Shan-boop-cmd/Saathi_Chair/Hardware/Samples/foot impedance circuit.png

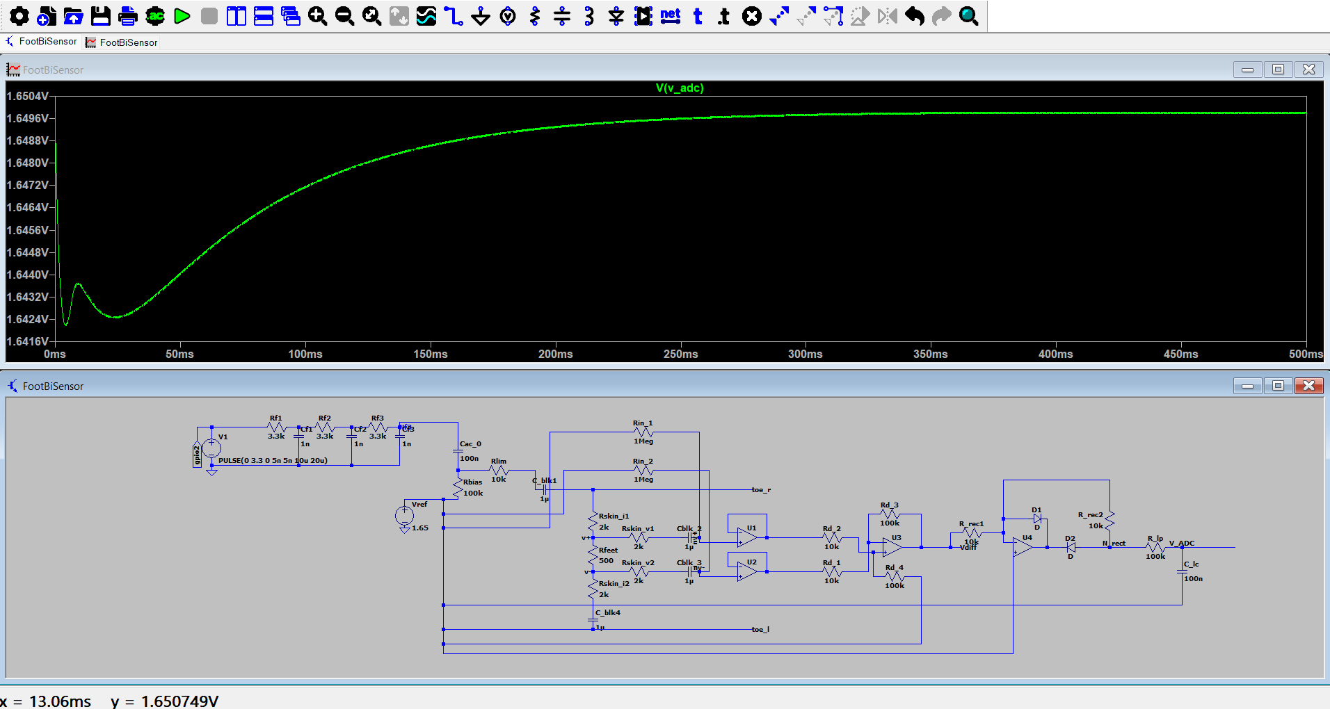
Hardware/Samples/foot impedance circuit.png
