Shan-boop-cmd/Saathi_Chair/Hardware/Samples/opamp circuit_PVDF.jpeg

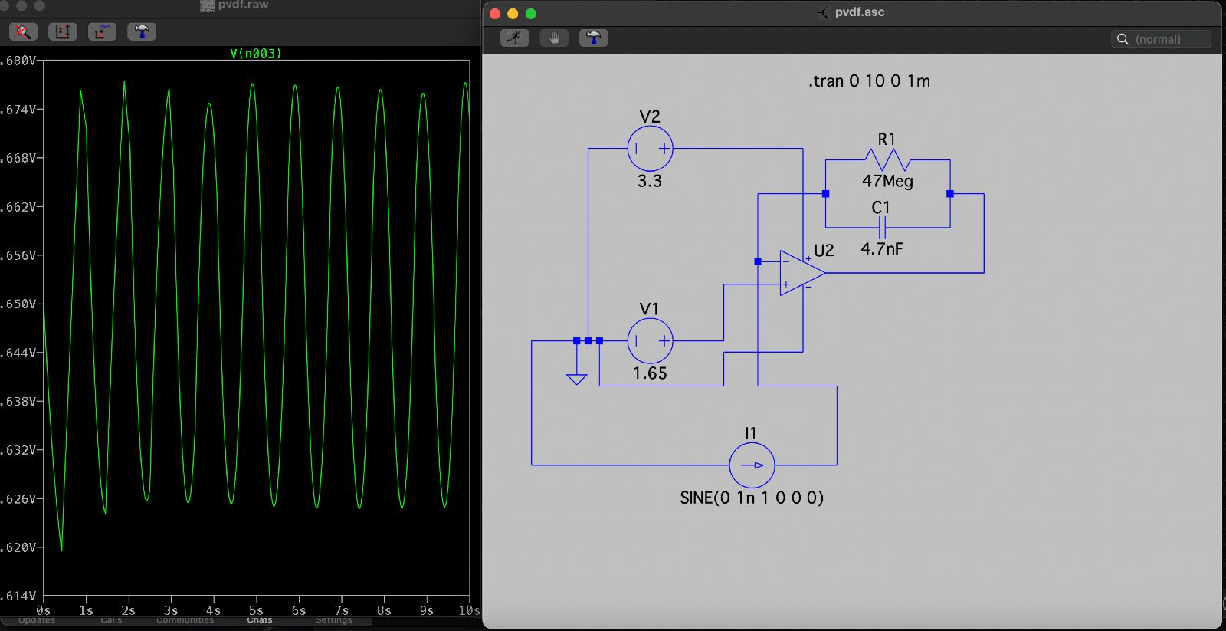
Hardware/Samples/opamp circuit_PVDF.jpeg
