Shan-boop-cmd/Saathi_Chair/Hardware/Schematics/schematic_bcg_frontend.png

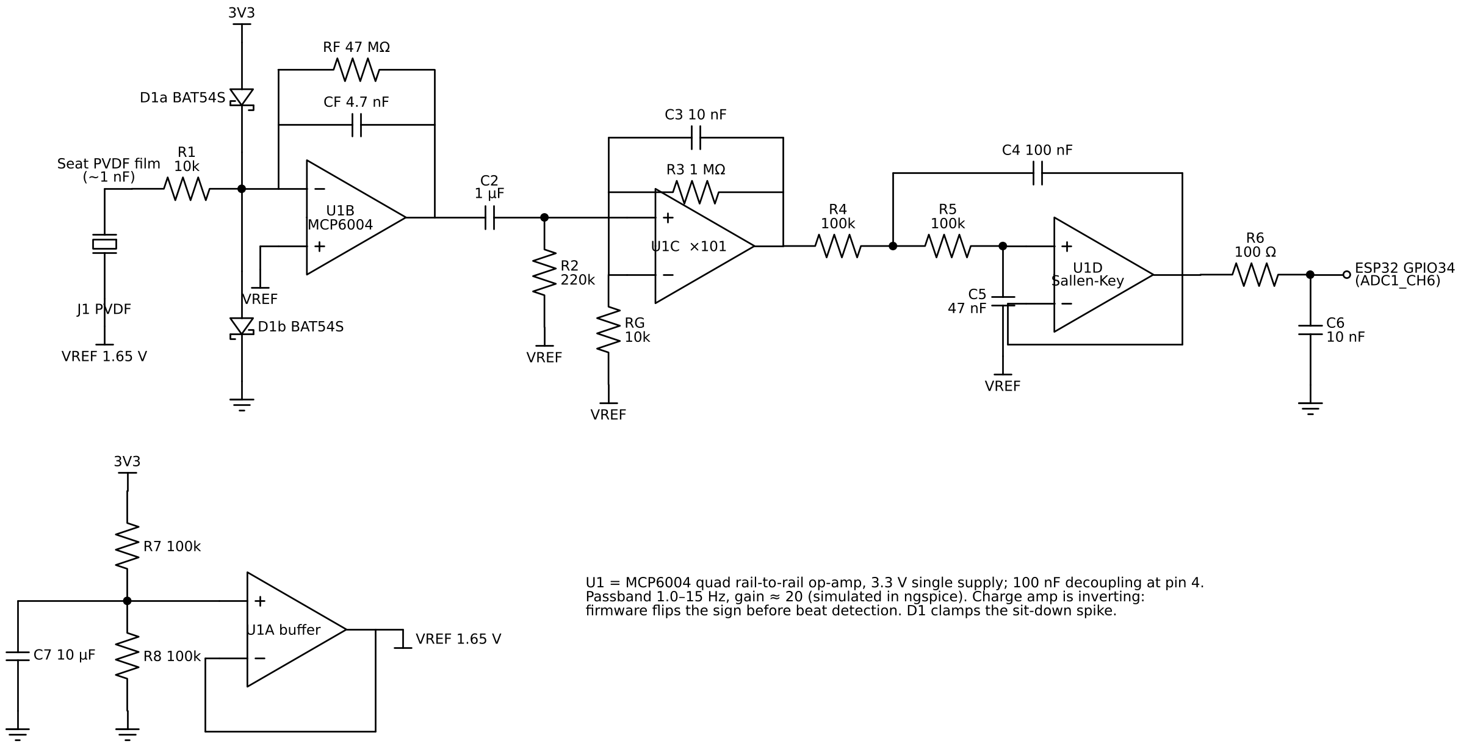
Hardware/Schematics/schematic_bcg_frontend.png
