Shan-boop-cmd/Saathi_Chair/Hardware/Schematics/schematic_bioimpedance.png

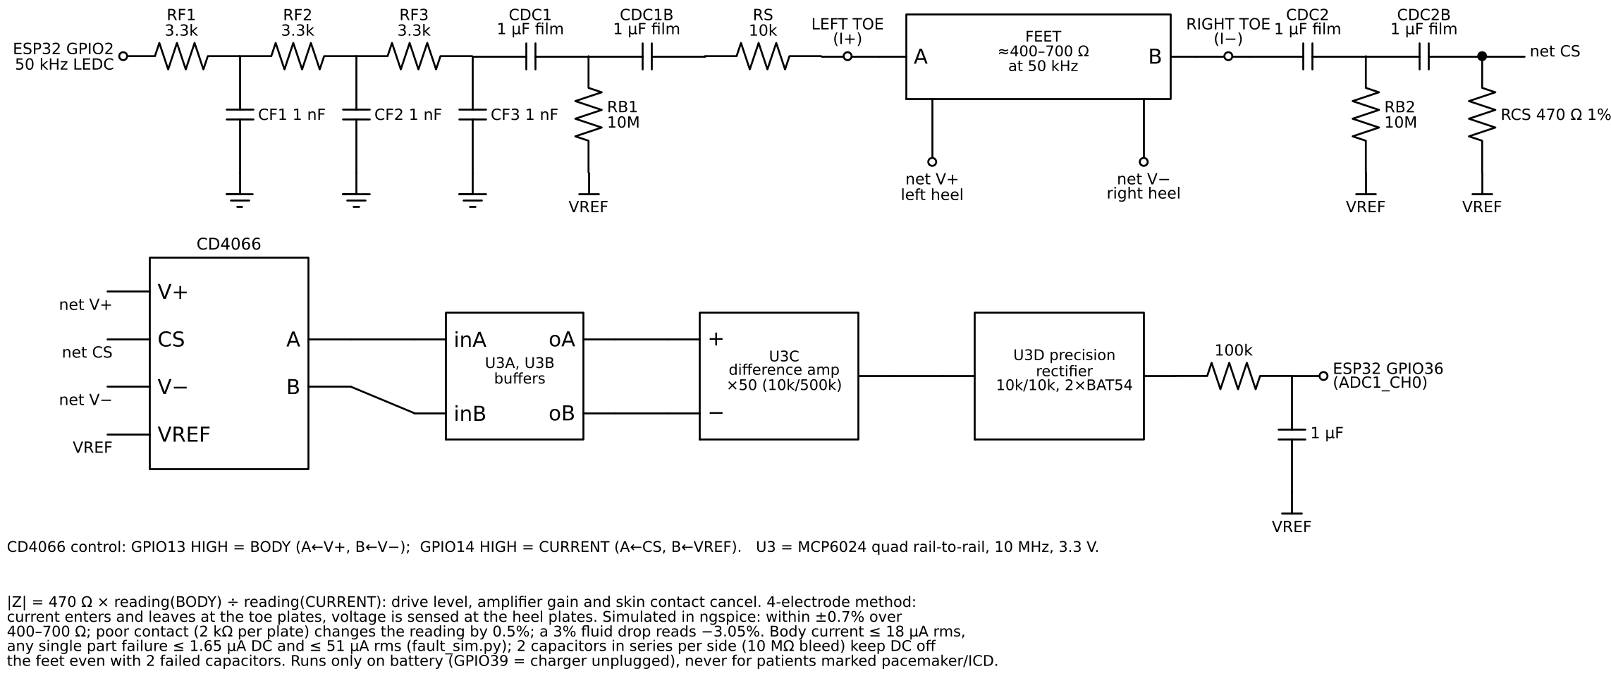
Hardware/Schematics/schematic_bioimpedance.png
