Shan-boop-cmd/Saathi_Chair/Hardware/Schematics/schematic_system.png

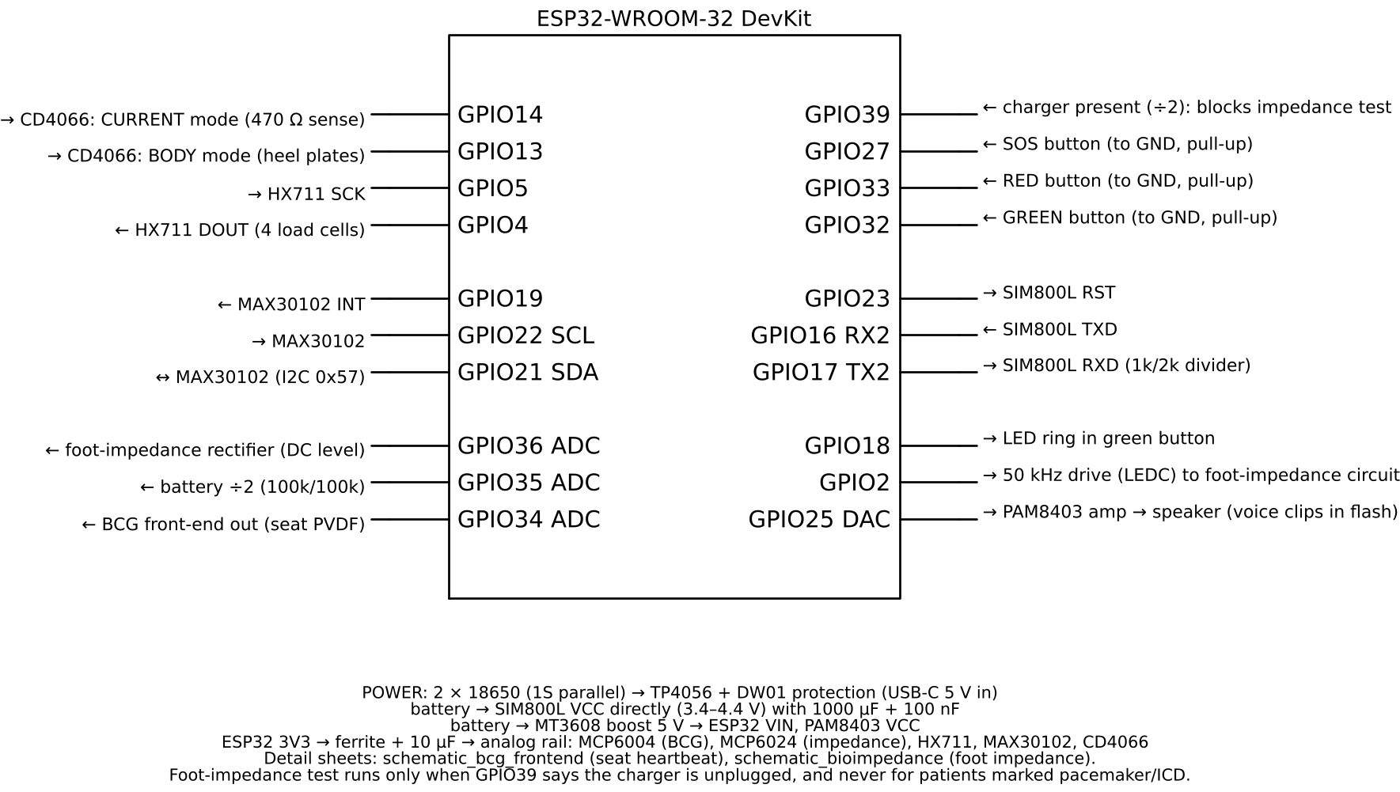
Hardware/Schematics/schematic_system.png
