Shan-boop-cmd/Saathi_Chair/CAD/leg_foot.stl

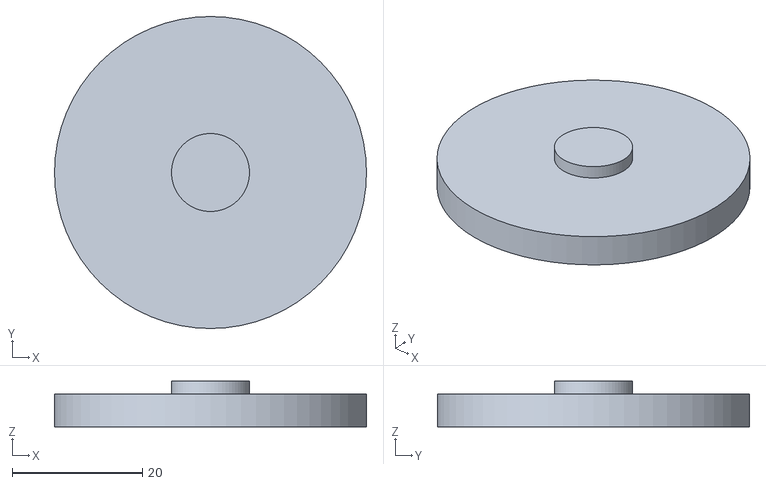
[picture p8: CAD file, 2026-10-25]
CAD/leg_foot.stl
48.0 x 48.0 x 7.00
