Shan-boop-cmd/Saathi_Chair/CAD/finger_cradle.stl

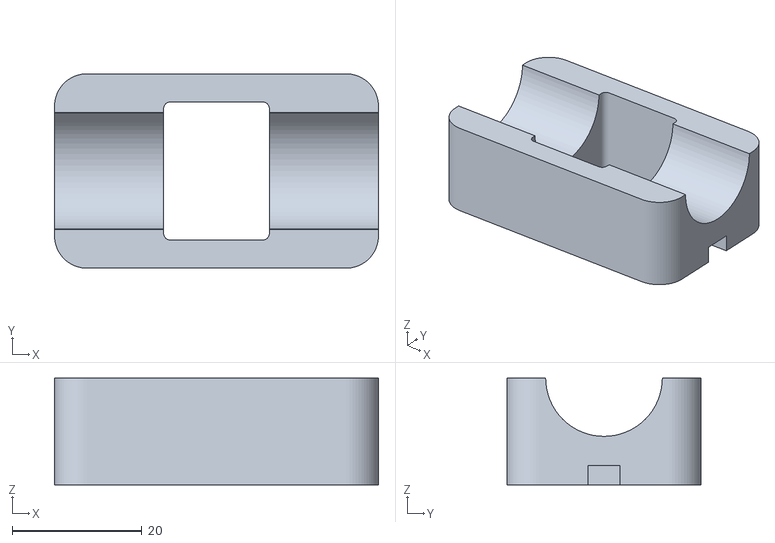
[picture p9: CAD file, 2026-10-25]
CAD/finger_cradle.stl
50.0 x 30.0 x 16.5
