Shan-boop-cmd/Saathi_Chair/CAD/footrest_clamp.stl

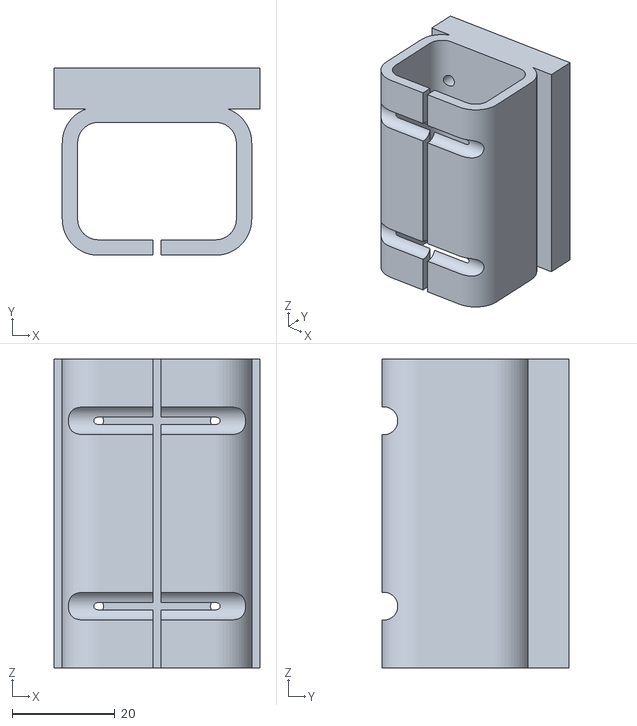
[picture p10: CAD file, 2026-10-25]
CAD/footrest_clamp.stl
40.0 x 36.4 x 60.0
