Shan-boop-cmd/Saathi_Chair/CAD/leg_cup.stl

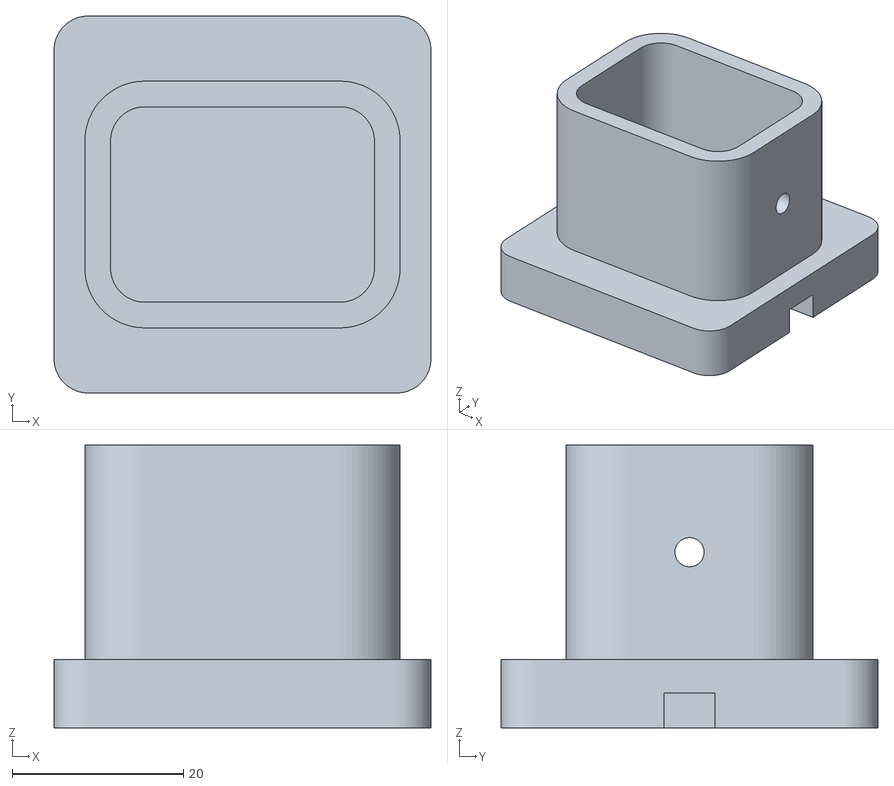
[picture p11: CAD file, 2026-10-25]
CAD/leg_cup.stl
44.0 x 44.0 x 33.0
