Shan-boop-cmd/Saathi_Chair/Testing/bidmc_selftest_results.csv

record | start_s | est_bpm | ref_bpm | quality
synthetic | 0 | 90.90909090909089 | 91.00549848570763 | 1.0
synthetic | 0 | 66.37168141592869 | 66.25984377952969 | 1.0
synthetic | 0 | 84.74576271186439 | 84.65864611548922 | 1.0
synthetic | 0 | 70.42253521126729 | 70.27924472328918 | 1.0
synthetic | 0 | 107.91366906474802 | 107.78006871786049 | 1.0
synthetic | 0 | 109.48905109489014 | 109.3890863686714 | 1.0
synthetic | 0 | 62.24066390041494 | 62.07760268380265 | 1.0
synthetic | 0 | 53.76344086021507 | 53.801281690550134 | 1.0
synthetic | 0 | 68.49315068493155 | 68.4981849492181 | 1.0
synthetic | 0 | 70.42253521126759 | 70.35972345503826 | 1.0
synthetic | 0 | 62.24066390041503 | 62.07649245771442 | 1.0
synthetic | 0 | 86.20689655172417 | 86.01757813308626 | 1.0
synthetic | 0 | 53.191489361702125 | 53.21317542055802 | 1.0
synthetic | 0 | 59.88023952095836 | 59.90027083182772 | 1.0
synthetic | 0 | 107.14285714285671 | 106.97778137678596 | 1.0
synthetic | 0 | 93.74999999999991 | 93.91873568976689 | 1.0
synthetic | 0 | 58.36575875486389 | 58.349320975334074 | 1.0
synthetic | 0 | 53.00353356890465 | 53.02678273052452 | 1.0
synthetic | 0 | 92.59259259259264 | 92.63054457773187 | 1.0
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
