Shan-boop-cmd/Saathi_Chair/Data Analysis/Data Files/Generated Readings/measured.csv

patient_id | day | missed | test_hour | q_orthopnea | q_breathless | q_swelling | sit_count | weight_kg | foot_z_ohm | rest_hr_bpm | spo2_pct | resp_rate_bpm | ptt_ms
P001 | 0 | 0 | 9.91 | 0.0 | 0.0 | 1.0 | 13 | 60.33204352145223 | 546.447287963602 | 79.0515206221356 | 98.27369513195009 | 18.8671875 | 268.5455483793646
P001 | 1 | 0 | 9.01 | 0.0 | 0.0 | 0.0 | 8 | 59.81697966099328 | 570.1466164701162 | 76.72684458398743 | 98.88820143704433 | 17.8125 | 287.64204176003716
P001 | 2 | 0 | 7.85 | 0.0 | 0.0 | 0.0 | 8 | 59.76590305791257 | 582.479247670577 | 79.78779840848804 | 96.29210065592875 | 19.6875 | 269.94164218866956
P001 | 3 | 0 | 9.87 | 0.0 | 0.0 | 0.0 | 12 | 59.92587319720296 | 620.9475443278347 | 82.30468161975055 | 95.80848137108288 | 16.875 | 266.9340652301173
P001 | 4 | 0 | 17.09 | 0.0 | 0.0 | 0.0 | 13 | 59.9317326467787 | 592.4557089813584 | 82.30468161975055 | 98.38872076989438 | 15.9375 | 279.7225530089804
P001 | 5 | 0 | 8.84 | 0.0 | 1.0 | 0.0 | 9 | 60.28908888607442 | 593.4238426872905 | 78.89549761394302 | 99.37964468875505 | 17.6953125 | 275.89471182249883
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
