Shan-boop-cmd/Saathi_Chair/Data Analysis/Data Files/Measured Readings/alerts.csv

patient_id | day | measured | score | danger | reason | in_baseline | status | weight_rejected | spo2_low | alert | rule | split | weight_kg | foot_z_ohm | rest_hr_bpm | spo2_pct | resp_rate_bpm | ptt_ms | sit_count | test_hour
P001 | 0 | 1 |  |  |  | 1 | learning |  | 0 | 0 |  | train | 38.4 | 546.0 | 90.6 |  |  |  | 11 | 7.77
P001 | 1 | 1 |  |  |  | 1 | learning |  | 0 | 0 |  | train | 38.7 |  | 85.6 | 97.6 | 12.4 | 258.9 | 11 | 7.47
P001 | 2 | 1 |  |  |  | 1 | learning |  | 0 | 0 |  | train | 38.5 | 532.0 | 93.3 | 96.7 | 17.7 | 264.0 | 14 | 9.66
P001 | 3 | 1 |  |  |  | 1 | learning |  | 0 | 0 |  | train | 37.8 | 539.0 | 87.2 | 95.9 | 15.8 | 257.2 | 7 | 8.7
P001 | 4 | 1 |  |  |  | 1 | learning |  | 0 | 0 |  | train | 38.1 | 527.0 | 91.2 | 95.8 | 15.6 | 265.0 | 2 | 8.32
P001 | 5 | 1 |  |  |  | 1 | learning |  | 0 | 0 |  | train | 38.4 | 555.0 | 82.1 | 97.2 | 16.6 | 258.4 | 7 | 7.06
P001 | 6 | 1 |  |  |  | 1 | learning |  | 0 | 0 |  | train | 38.3 | 544.0 | 83.3 | 98.9 | 17.5 | 242.5 | 6 | 8.52
P001 | 7 | 1 |  |  |  | 1 | learning |  | 0 | 0 |  | train | 39.1 | 527.0 | 92.4 | 97.7 | 14.4 | 249.6 | 12 | 20.95
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
