Shan-boop-cmd/Saathi_Chair/Data Analysis/Data Files/Measured Readings/daily.csv

patient_id | day | missed | test_hour | weight_kg | foot_z_ohm | rest_hr_bpm | spo2_pct | resp_rate_bpm | ptt_ms | q_orthopnea | q_breathless | q_swelling | sit_count
P001 | 0 | 0 | 7.77 | 38.4 | 546.0 | 90.4 |  |  |  | 0.0 | 0.0 | 0.0 | 11
P001 | 1 | 0 | 7.47 | 38.7 |  | 86.0 | 97.6 | 12.4 | 232.1 | 0.0 | 0.0 | 0.0 | 11
P001 | 2 | 0 | 9.66 | 38.5 | 532.0 | 92.7 | 96.7 | 17.7 | 236.4 | 0.0 | 0.0 | 0.0 | 14
P001 | 3 | 0 | 8.7 | 37.8 | 540.0 | 87.5 | 95.9 | 15.8 | 230.3 | 1.0 | 0.0 | 0.0 | 7
P001 | 4 | 0 | 8.32 | 38.1 | 527.0 | 91.4 | 95.8 | 15.6 | 237.5 | 0.0 | 0.0 | 0.0 | 2
P001 | 5 | 0 | 7.06 | 38.4 | 555.0 | 82.1 | 97.2 | 16.7 | 231.6 | 0.0 | 0.0 | 0.0 | 7
P001 | 6 | 0 | 8.52 | 38.3 | 543.0 | 83.2 | 98.9 | 17.5 | 215.7 | 0.0 | 0.0 | 0.0 | 6
P001 | 7 | 0 | 20.95 | 39.1 | 527.0 | 92.6 | 97.7 | 14.4 | 222.0 | 0.0 | 0.0 | 0.0 | 12
P001 | 8 | 1 |  |  |  |  |  |  |  |  |  |  | 5
P001 | 9 | 1 |  |  |  |  |  |  |  |  |  |  | 8
P001 | 10 | 0 | 8.34 | 38.2 | 552.0 | 90.7 | 96.8 | 15.9 | 239.0 | 0.0 | 0.0 | 0.0 | 5
P001 | 11 | 1 |  |  |  |  |  |  |  |  |  |  | 7
P001 | 12 | 0 | 9.74 | 39.0 |  | 85.6 | 97.8 | 14.7 | 224.9 | 0.0 | 0.0 | 0.0 | 7
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
