Shan-boop-cmd/Saathi_Chair/Data Analysis/Data Files/Measured Readings/measured.csv

patient_id | day | missed | test_hour | weight_kg | foot_z_ohm | rest_hr_bpm | hr_bcg_bpm | hr_ppg_bpm | hr_source | spo2_pct | resp_rate_bpm | ptt_ms | q_orthopnea | q_breathless | q_swelling | sit_count
P001 | 0 | 0 | 7.77 | 38.4 | 546.0 | 90.6 | 90.6 |  | bcg |  |  |  | 0.0 | 0.0 | 0.0 | 11
P001 | 1 | 0 | 7.47 | 38.7 |  | 85.6 | 85.5 | 85.7 | both | 97.6 | 12.4 | 258.9 | 0.0 | 0.0 | 0.0 | 11
P001 | 2 | 0 | 9.66 | 38.5 | 532.0 | 93.3 | 92.9 | 93.7 | both | 96.7 | 17.7 | 264.0 | 0.0 | 0.0 | 0.0 | 14
P001 | 3 | 0 | 8.7 | 37.8 | 539.0 | 87.2 | 87.5 | 87.0 | both | 95.9 | 15.8 | 257.2 | 1.0 | 0.0 | 0.0 | 7
P001 | 4 | 0 | 8.32 | 38.1 | 527.0 | 91.2 | 91.5 | 90.9 | both | 95.8 | 15.6 | 265.0 | 0.0 | 0.0 | 0.0 | 2
P001 | 5 | 0 | 7.06 | 38.4 | 555.0 | 82.1 | 82.0 | 82.2 | both | 97.2 | 16.6 | 258.4 | 0.0 | 0.0 | 0.0 | 7
P001 | 6 | 0 | 8.52 | 38.3 | 544.0 | 83.3 | 83.2 | 83.3 | both | 98.9 | 17.5 | 242.5 | 0.0 | 0.0 | 0.0 | 6
P001 | 7 | 0 | 20.95 | 39.1 | 527.0 | 92.4 | 92.4 | 92.3 | both | 97.7 | 14.4 | 249.6 | 0.0 | 0.0 | 0.0 | 12
P001 | 8 | 1 |  |  |  |  |  |  | missed |  |  |  |  |  |  | 5
P001 | 9 | 1 |  |  |  |  |  |  | missed |  |  |  |  |  |  | 8
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
