Shan-boop-cmd/Saathi_Chair/Data Analysis/Data Files/Measured Readings/patients.csv

patient_id | sex | age | has_event | admission_day | lead_days | phenotype | has_implant | usual_test_hour | miss_rate | symptom_report | weight_gain_kg | z_drop_frac | hr_rise_bpm | spo2_drop | rr_rise | ptt_change_ms | activity_drop_frac
P001 | M | 72 | 1 | 37.0 | 8.0 | congestive | 0 | 8.5 | 0.088 | 0.41 | 3.09 | 0.05 | 11.1 | 0.48 | 4.7 | -0.4 | 0.38
P002 | F | 79 | 0 |  |  | stable | 0 | 17.0 | 0.087 | 0.73 | 0.0 | 0.0 | 0.0 | 0.0 | 0.0 | 0.0 | 0.0
P003 | M | 81 | 1 | 32.0 | 7.0 | no_weight_gain | 0 | 16.4 | 0.067 | 0.74 | 0.03 | 0.013 | 10.1 | 2.07 | 3.9 | 4.6 | 0.38
P004 | M | 62 | 0 |  |  | stable | 0 | 8.4 | 0.143 | 0.25 | 0.0 | 0.0 | 0.0 | 0.0 | 0.0 | 0.0 | 0.0
P005 | M | 69 | 0 |  |  | stable | 0 | 18.0 | 0.04 | 0.23 | 0.0 | 0.0 | 0.0 | 0.0 | 0.0 | 0.0 | 0.0
P006 | M | 75 | 1 | 34.0 | 7.0 | congestive | 0 | 16.6 | 0.076 | 0.28 | 1.47 | 0.079 | 11.7 | 0.71 | 1.8 | -9.0 | 0.38
P007 | M | 60 | 1 | 31.0 | 9.0 | congestive | 0 | 17.0 | 0.146 | 0.26 | 1.65 | 0.068 | 10.4 | 0.77 | 1.7 | 3.7 | 0.39
P008 | F | 73 | 0 |  |  | stable | 1 | 8.1 | 0.149 | 0.61 | 0.0 | 0.0 | 0.0 | 0.0 | 0.0 | 0.0 | 0.0
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
