Shan-boop-cmd/Saathi_Chair/Data Analysis/Data Files/Measured Readings/truth.csv

patient_id | day | worsening | severity | days_to_admission | confounder
P001 | 0 | 0 | 0.0 | 37.0
P001 | 1 | 0 | 0.0 | 36.0
P001 | 2 | 0 | 0.0 | 35.0
P001 | 3 | 0 | 0.0 | 34.0
P001 | 4 | 0 | 0.0 | 33.0
P001 | 5 | 0 | 0.0 | 32.0
P001 | 6 | 0 | 0.0 | 31.0
P001 | 7 | 0 | 0.0 | 30.0
P001 | 8 | 0 | 0.0 | 29.0
P001 | 9 | 0 | 0.0 | 28.0
P001 | 10 | 0 | 0.0 | 27.0
P001 | 11 | 0 | 0.0 | 26.0
P001 | 12 | 0 | 0.0 | 25.0
P001 | 13 | 0 | 0.0 | 24.0 | festival
P001 | 14 | 0 | 0.0 | 23.0 | festival
P001 | 15 | 0 | 0.0 | 22.0 | festival
P001 | 16 | 0 | 0.0 | 21.0
P001 | 17 | 0 | 0.0 | 20.0
P001 | 18 | 0 | 0.0 | 19.0
P001 | 19 | 0 | 0.0 | 18.0
P001 | 20 | 0 | 0.0 | 17.0
P001 | 21 | 0 | 0.0 | 16.0
P001 | 22 | 0 | 0.0 | 15.0
P001 | 23 | 0 | 0.0 | 14.0
P001 | 24 | 0 | 0.0 | 13.0
P001 | 25 | 0 | 0.0 | 12.0
P001 | 26 | 0 | 0.0 | 11.0 | heavy_clothing
P001 | 27 | 0 | 0.0 | 10.0
P001 | 28 | 0 | 0.0 | 9.0
P001 | 29 | 1 | 0.09 | 8.0
P001 | 30 | 1 | 0.2 | 7.0
P001 | 31 | 1 | 0.321 | 6.0
P001 | 32 | 1 | 0.447 | 5.0
P001 | 33 | 1 | 0.58 | 4.0
P001 | 34 | 1 | 0.716 | 3.0
P001 | 35 | 1 | 0.856 | 2.0
P001 | 36 | 1 | 1.0 | 1.0
P002 | 0 | 0 | 0.0
P002 | 1 | 0 | 0.0
P002 | 2 | 0 | 0.0
P002 | 3 | 0 | 0.0
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
