Shan-boop-cmd/Saathi_Chair/Hardware/Verification/bcg_amplitude_sweep.png

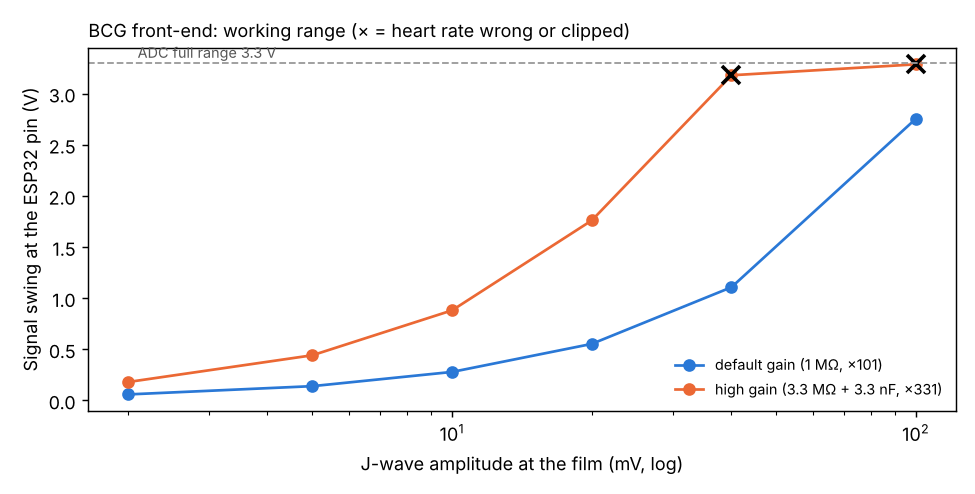
Hardware/Verification/bcg_amplitude_sweep.png
