Shan-boop-cmd/Saathi_Chair/Hardware/Verification/bcg_frequency_response.png

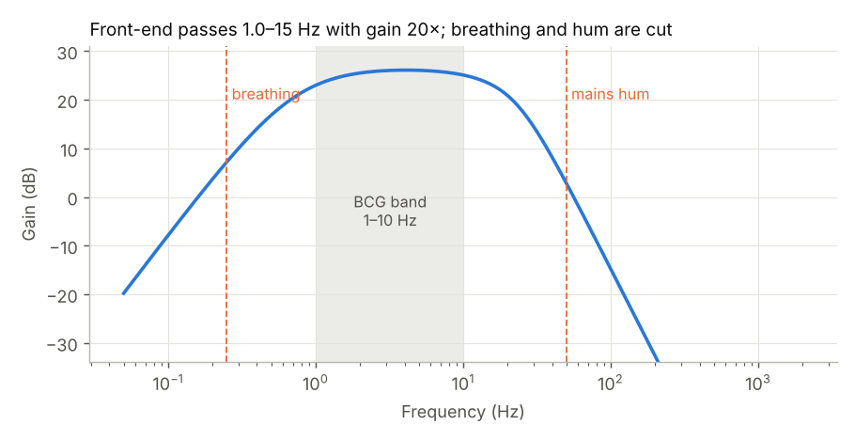
Hardware/Verification/bcg_frequency_response.png
