Shan-boop-cmd/Saathi_Chair/Hardware/Verification/bcg_transient.png

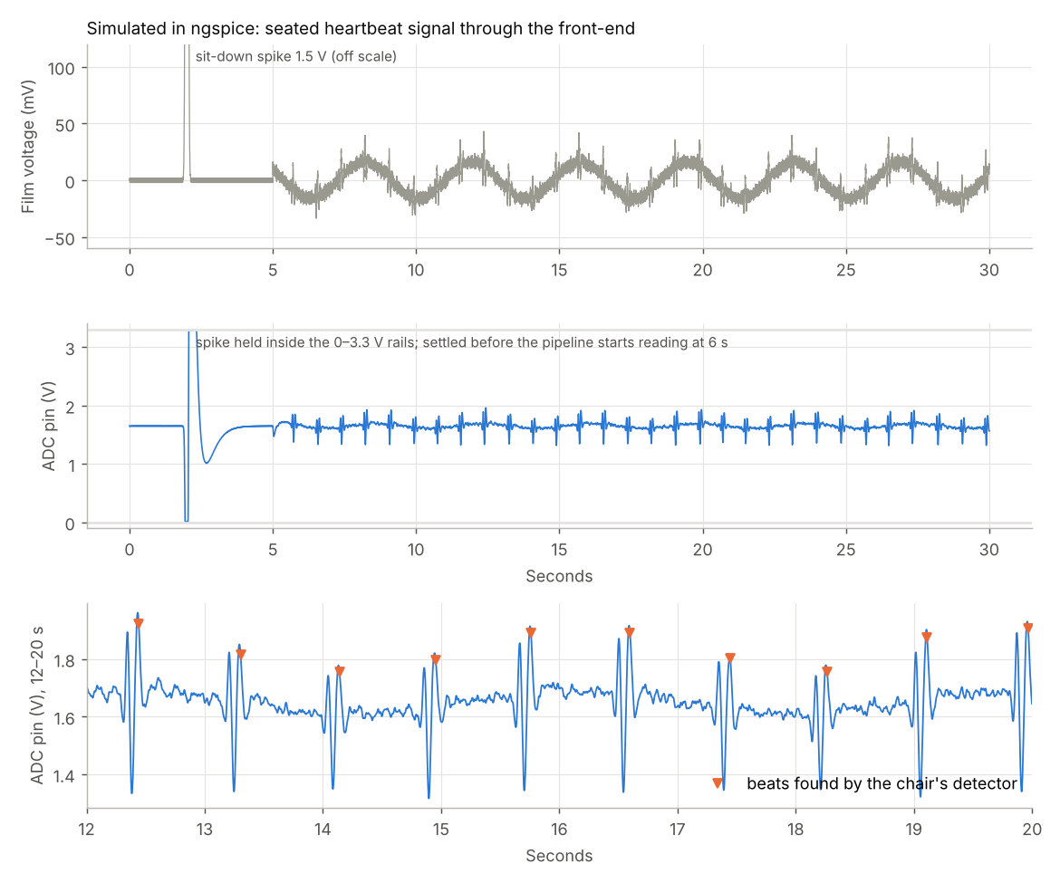
Hardware/Verification/bcg_transient.png
