Shan-boop-cmd/Saathi_Chair/Hardware/Verification/bioimpedance_accuracy.png

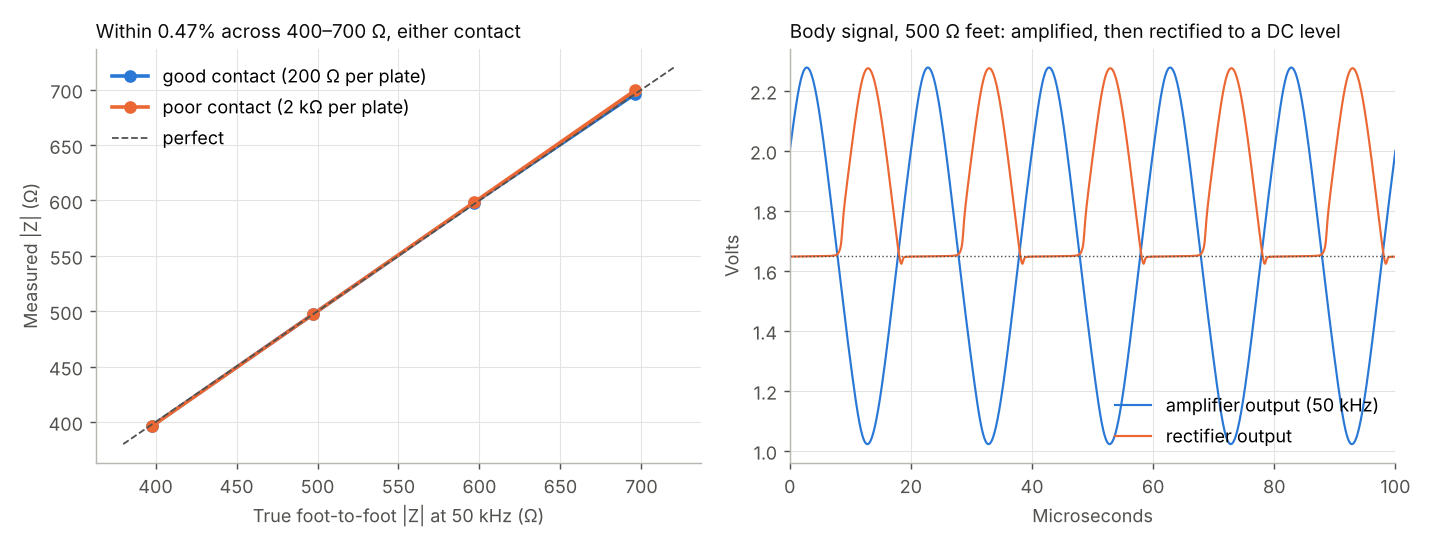
Hardware/Verification/bioimpedance_accuracy.png
