Shan-boop-cmd/Saathi_Chair/Verification/real_signal_check.png

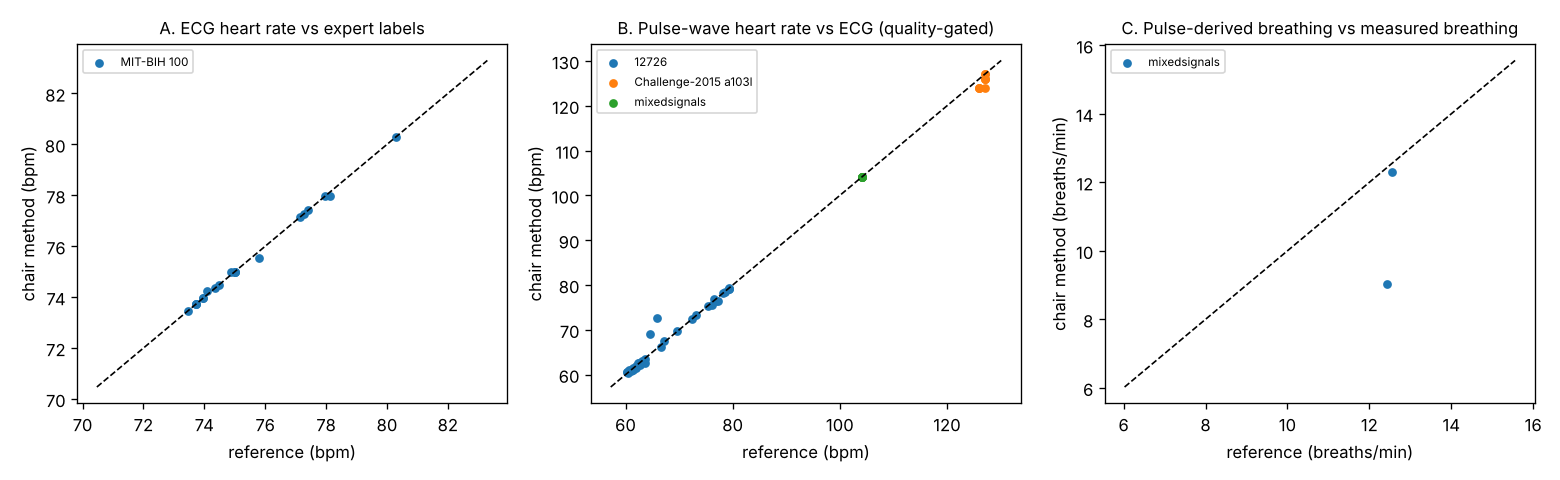
Verification/real_signal_check.png
