Shan-boop-cmd/Saathi_Chair/Verification/robustness.png

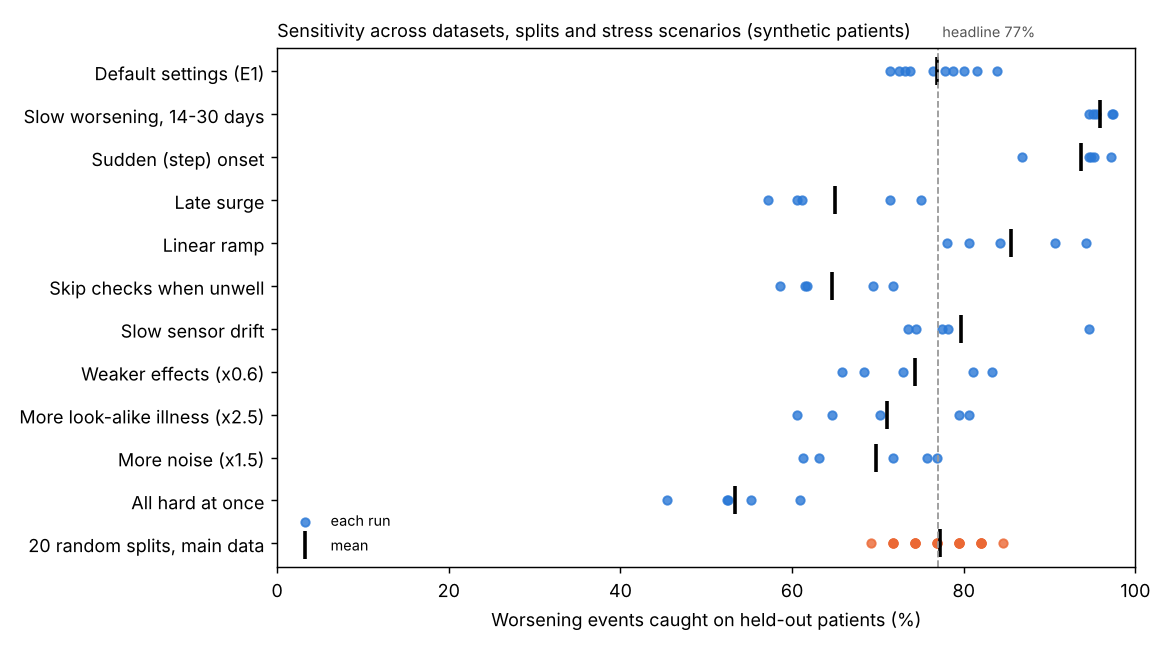
Verification/robustness.png
