Shan-boop-cmd/Saathi_Chair/Verification/tradeoff_curve.png

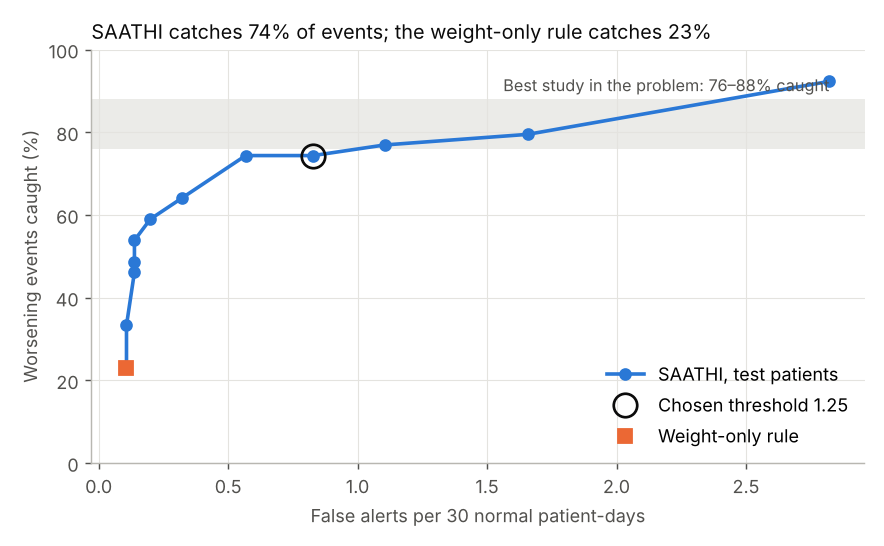
Verification/tradeoff_curve.png
