Shan-boop-cmd/Saathi_Chair/Hardware/opamp_pvdf.asc

C1: Cap; 4.7nF
I1: current; SINE(0 1n 1 0 0 0)
R1: res; 47Meg
U2: UniversalOpAmp2
V1: voltage; 1.65
V2: voltage; 3.3
Named nets: 0
.tran 0 10 0 1m
