Shan-boop-cmd/Saathi_Chair/Hardware/FootBiSensor.asc

C_blk1: cap; 1µ
C_blk4: cap; 1µ
C_lc: cap; 100n
Cac_0: cap; 100n
Cblk_2: cap; 1µ
Cblk_3: cap; 1µ
Cf1: cap; 1n
Cf2: cap; 1n
Cf3: cap; 1n
D1: diode
D2: diode
R_lp: res; 100k
R_rec1: res; 10k
R_rec2: res; 10k
Rbias: res; 100k
Rd_1: res; 10k
Rd_2: res; 10k
Rd_3: res; 100k
Rd_4: res; 100k
Rf1: res; 3.3k
Rf2: res; 3.3k
Rf3: res; 3.3k
Rfeet: res; 500
Rin_1: res; 1Meg
Rin_2: res; 1Meg
Rlim: res; 10k
Rskin_i1: res; 2k
Rskin_i2: res; 2k
Rskin_v1: res; 2k
Rskin_v2: res; 2k
U1: opamp
U2: opamp
U3: opamp
U4: opamp
V1: voltage; PULSE(0 3.3 0 5n 5n 10u 20u)
Vref: voltage; 1.65
Named nets: gpio2, 0, toe_r, toe_l, v+, v-, nv+, nv-, Vdiff, N_rect, V_ADC
Nf3
.tran 0.5u 500m
.lib opamp.sub
