Shan-boop-cmd/Saathi_Chair/Hardware/Chair_Firmware/saathi_chair.ino

// SAATHI chair firmware for the ESP32 (Arduino core 3.x).
// The code is in the .cpp/.h files in this folder (app.cpp has setup() and loop()).
//
// Libraries: "HX711" by Bogdan Necula, "SparkFun MAX3010x Pulse and Proximity Sensor Library".
// Board: "ESP32 Dev Module". Partition scheme: "Default 4MB with spiffs" (voice clips go in LittleFS).
// Demo build without sensors (e.g. Wokwi): set SAATHI_DEMO to 1 in config.h.
