Shan-boop-cmd/Saathi_Chair/(commit log)

2026-10-24 Added Foot Bio Impedance Sensor Simulation
2026-10-24 Bio Impedance Sample Signal
2026-10-25 Wokwi Simulation Files
    Created so that any user can run and simulate without errors, perfectly replicates the behaviour of our chair for 26 days
    [app.cpp, config.h, detector.cpp, detector.h, dsp.cpp, dsp.h, outbox.cpp]
2026-10-25 Chair firmware files
    The actual firmware files we need to upload to the chair's onboard ESP32. Currently runs on the created Demo data
2026-10-25 Added Schematic Files for simulation
2026-10-25 Added CAD files of Mounts
    [finger_cradle.stl, footrest_clamp.stl, leg_cup.stl, leg_foot.stl]
2026-10-25 Added BCG circuit plot
2026-10-25 Added Data Files
    Contains the demo data files and the Synthetic patient values
    [alerts.csv, daily.csv, measured.csv, patients.csv, truth.csv]
2026-10-25 Added Data Files
    Contains Data Files after measurement using the chair sensors
    [alerts.csv, daily.csv, measured.csv, patients.csv, truth.csv]
2026-10-25 Added Bill Of Materials (BOM)
    [BOM_Saathi.csv]
2026-10-25 Reorganised Files
    [alerts.csv, daily.csv, measured.csv, patients.csv, truth.csv]
2026-10-25 Added testing phase results and files
    [bidmc_selftest_results.csv]
2026-10-25 Added Pitchdeck and Sample pics
